JoinNico/Hovercraft_Control_System/hardware/SCH_V203无感无刷_2025-11-13.pdf

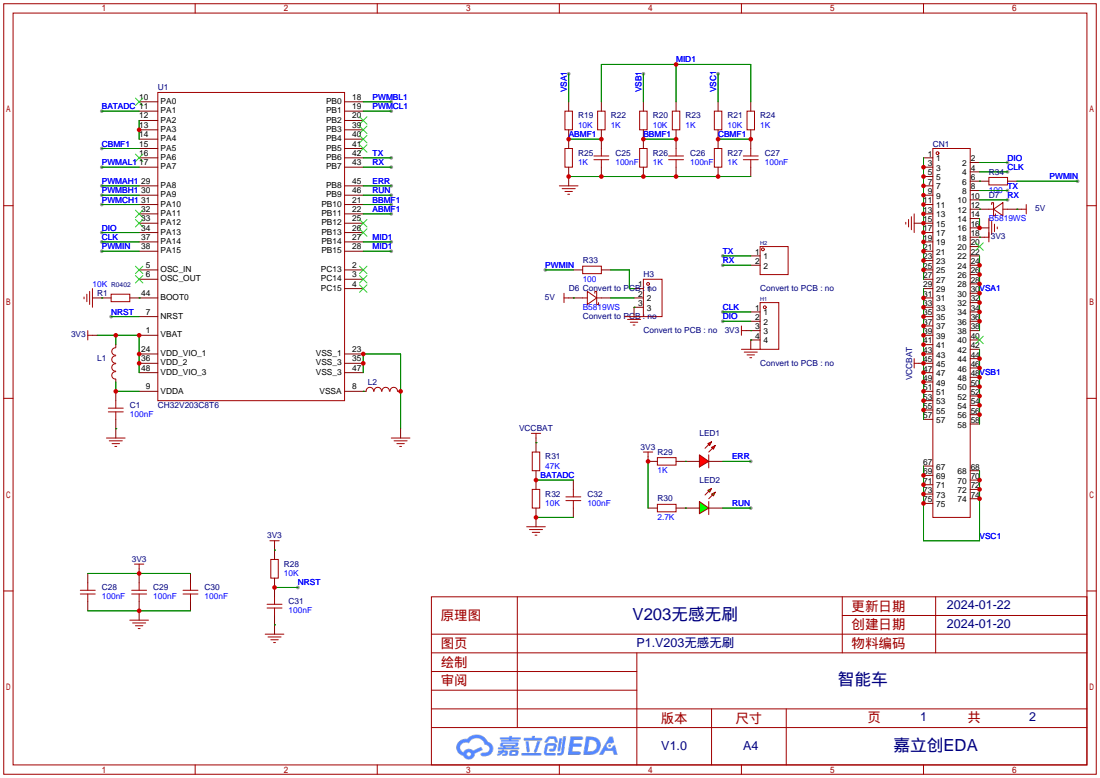
[picture p4: page 1]

Convert to PCB : no

# HO3 13 VB3 14 VS2 15 HO2 16 VB2 17 VS1 18

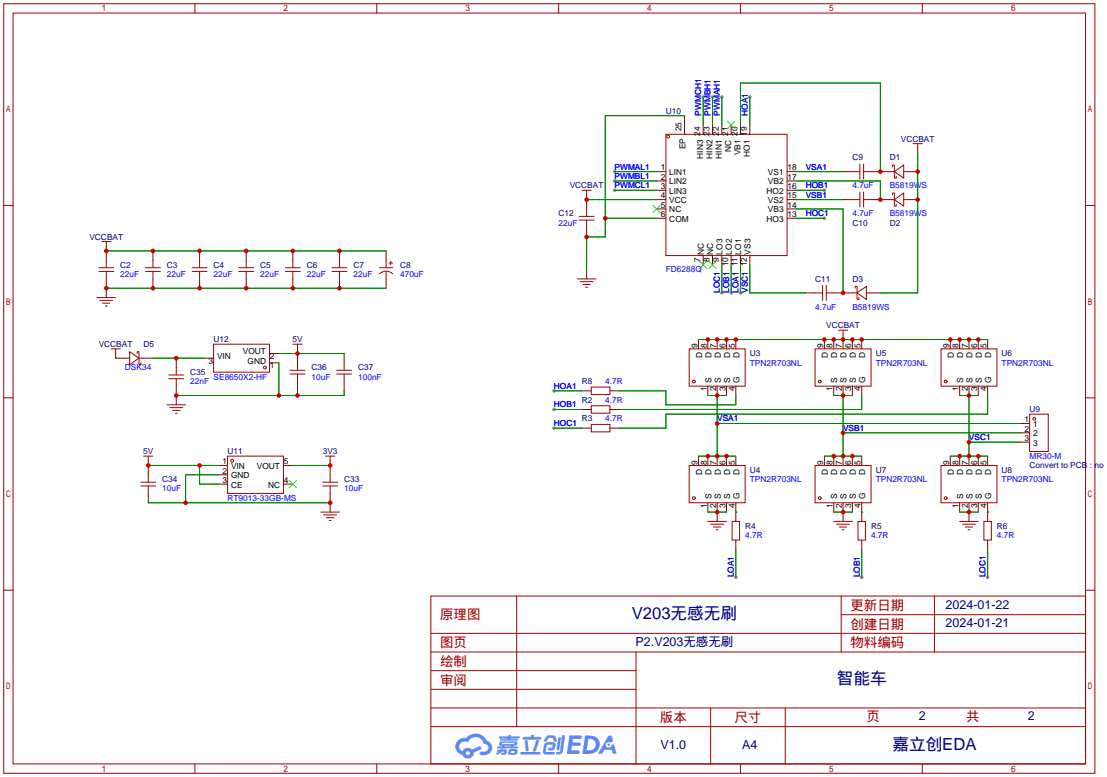
[picture p5: page 2]
