JoinNico/Hovercraft_Control_System/hardware/SCH_4路有刷驱动_2025-11-13.pdf

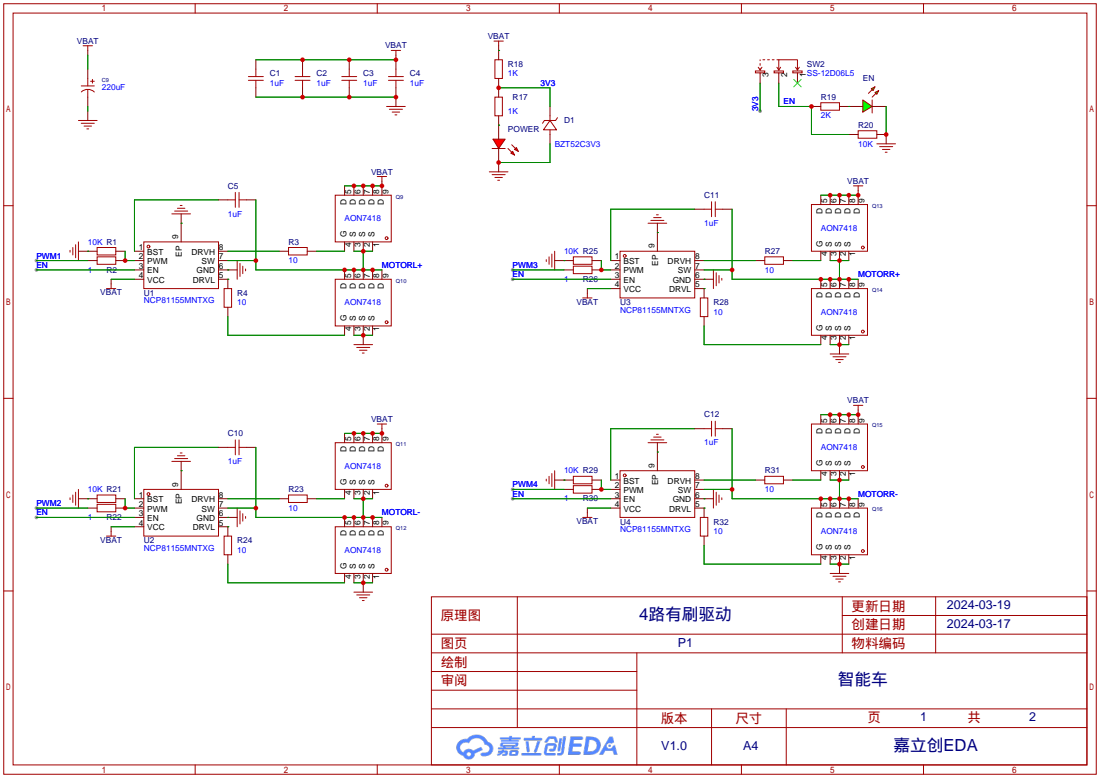
[picture p6: page 1]

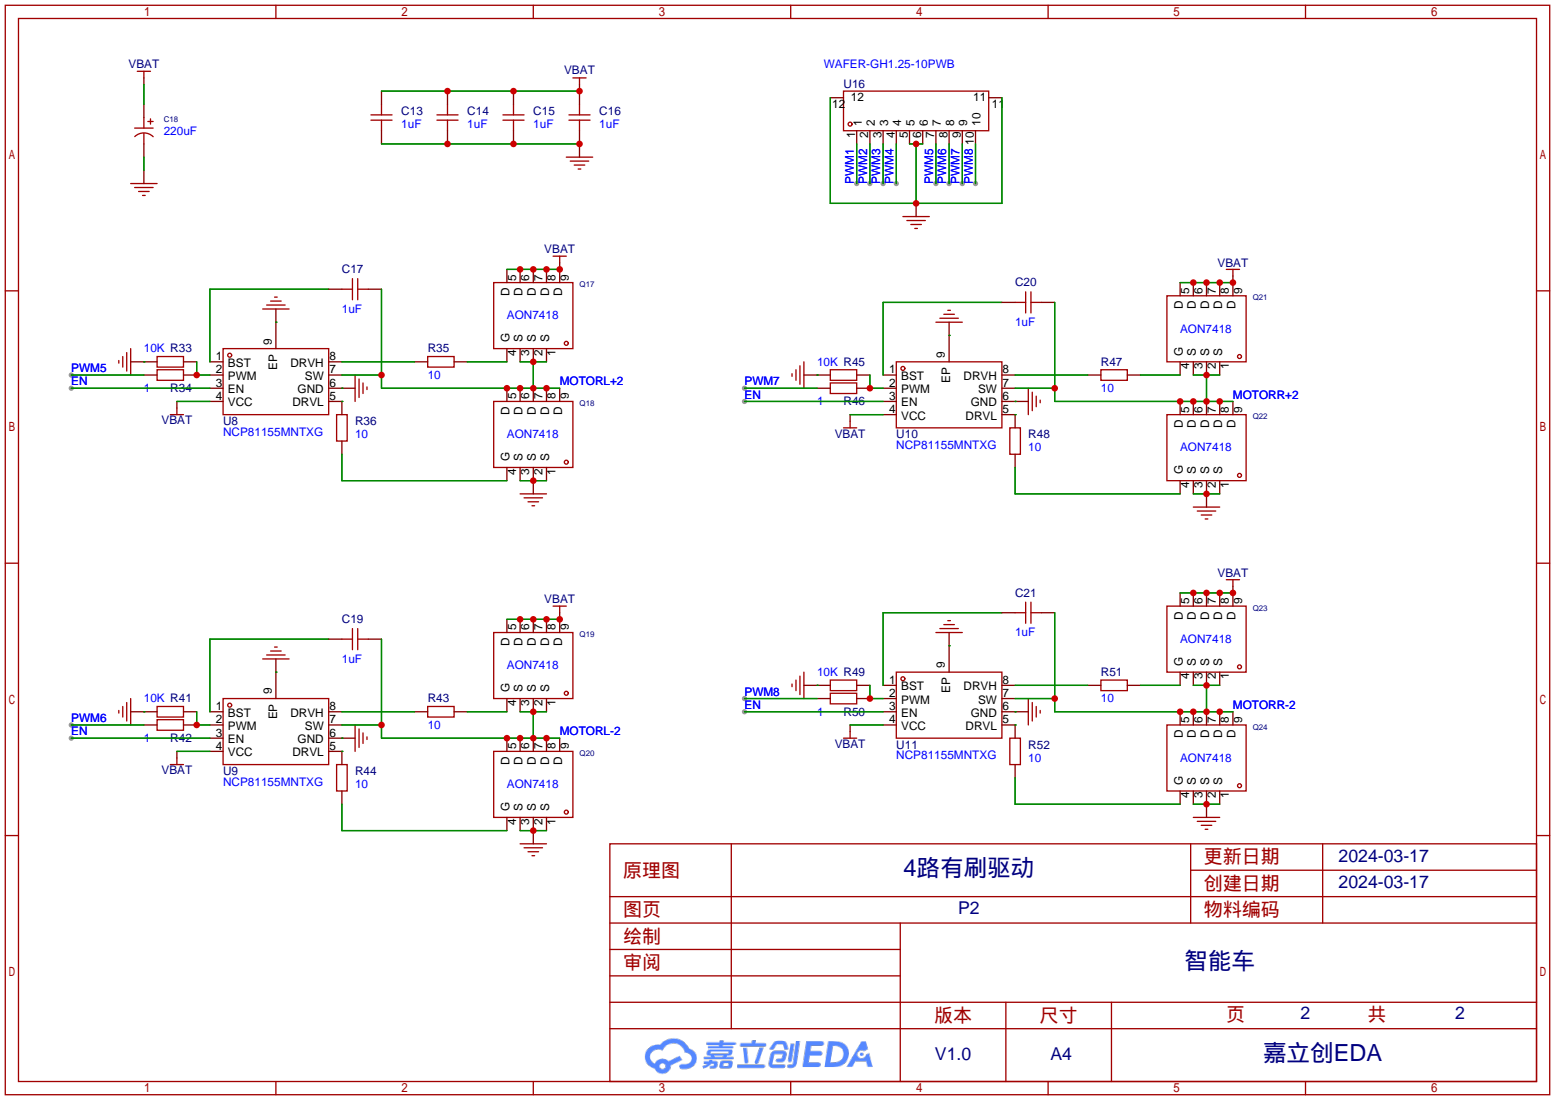
[picture p7: page 2]
