JoinNico/Hovercraft_Control_System/hardware/SCH_霍尔停车检测_2025-11-13.pdf

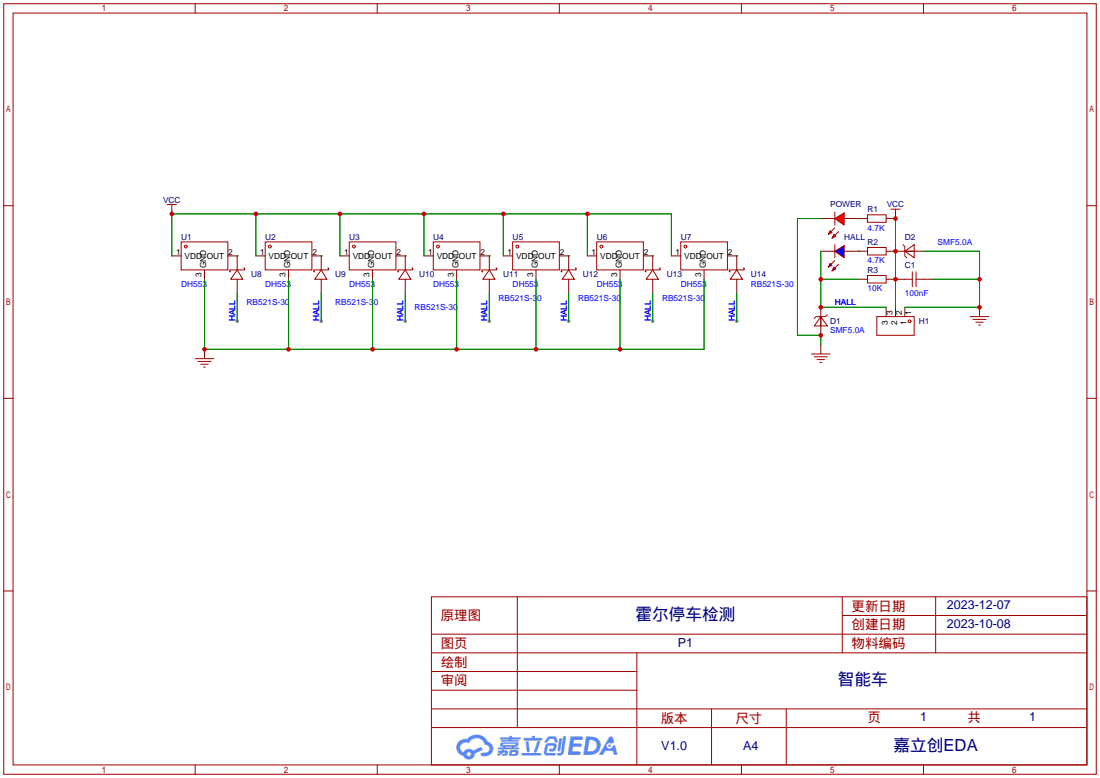
[picture p10: page 1]
