JoinNico/Hovercraft_Control_System/firmware/project/user/src/main.c

/*********************************************************************************************************************
* CH32V307VCT6 Opensourec Library 即（CH32V307VCT6 开源库）是一个基于官方 SDK 接口的第三方开源库
* Copyright (c) 2022 SEEKFREE 逐飞科技
*
* 本文件是CH32V307VCT6 开源库的一部分
*
* CH32V307VCT6 开源库 是免费软件
* 您可以根据自由软件基金会发布的 GPL（GNU General Public License，即 GNU通用公共许可证）的条款
* 即 GPL 的第3版（即 GPL3.0）或（您选择的）任何后来的版本，重新发布和/或修改它
*
* 本开源库的发布是希望它能发挥作用，但并未对其作任何的保证
* 甚至没有隐含的适销性或适合特定用途的保证
* 更多细节请参见 GPL
*
* 您应该在收到本开源库的同时收到一份 GPL 的副本
* 如果没有，请参阅<https://www.gnu.org/licenses/>
*
* 额外注明：
* 本开源库使用 GPL3.0 开源许可证协议 以上许可申明为译文版本
* 许可申明英文版在 libraries/doc 文件夹下的 GPL3_permission_statement.txt 文件中
* 许可证副本在 libraries 文件夹下 即该文件夹下的 LICENSE 文件
* 欢迎各位使用并传播本程序 但修改内容时必须保留逐飞科技的版权声明（即本声明）
*
* 文件名称          main
* 公司名称          成都逐飞科技有限公司
* 版本信息          查看 libraries/doc 文件夹内 version 文件 版本说明
* 开发环境          MounRiver Studio V1.8.1
* 适用平台          CH32V307VCT6
* 店铺链接          https://seekfree.taobao.com/
*
* 修改记录
* 日期                                      作者                             备注
* 2022-09-15        大W            first version
********************************************************************************************************************/
#include "zf_common_headfile.h"

#include "FreeRTOS_task.h"
//typedef enum
//{
//    FlASH_192_SRAM_128 = 0,
//    FLASH_224_SRAM_96,
//    FLASH_256_SRAM_64,
//    FLASH_288_RAM_32
//} FLASH_SRAM_DEFIN;
//
//void Config_Flash_SRAM(FLASH_SRAM_DEFIN SetFlashSRAM)
//{
//    uint8_t UserByte = FLASH_GetUserOptionByte() & 0xff; //get user option byte
//
//    switch(SetFlashSRAM)
//    {
//    case 0:
//        UserByte &= ~(0xc0); // SRAM_CODE_MODE = 00
//        break;
//    case 1:
//        UserByte &= ~(0xc0); // SRAM_CODE_MODE = 00
//        UserByte |= 0x7f;    // SRAM_CODE_MODE = 01
//        break;
//    case 2:
//        UserByte &= ~(0xc0); // SRAM_CODE_MODE = 00
//        UserByte |= 0xbf;    // SRAM_CODE_MODE = 10
//        break;
//    case 3:
//        UserByte |= 0xff;    // SRAM_CODE_MODE = 11
//        break;
//    default:
//        break;
//    }
//
//    FLASH_Unlock();
//    FLASH_ProgramOptionByteData(0x1ffff802, UserByte);
//    FLASH_Lock();
//}

int main (void)
{
    clock_init(SYSTEM_CLOCK_144M);      // 初始化芯片时钟 工作频率为 144MHz
    debug_init();                       // 务必保留，本函数用于初始化MPU 时钟 调试串口
//    wireless_uart_init();
    Delay_Init();
//    Config_Flash_SRAM(FlASH_192_SRAM_128 );
    my_flash_init();
    EC11_Init();
    UI_Init();
    motor_init();
    icm20602_init();
    Encoder_Init();
    adc_init(ADC1_IN9_B1,ADC_12BIT);
    //gpio_init(B0, GPO, 0, GPO_PUSH_PULL);
    buzzer_init();

    gpio_init(C4, GPO, 0, GPO_PUSH_PULL);

    ips200_init(IPS200_TYPE_PARALLEL8);

    while(1)
    {
        if(mt9v03x_init())
            ips200_show_string(0, 16, "mt9v03x reinit.");
        else
            break;
        system_delay_ms(500); // 短延时快速闪灯表示异常
    }

    ips200_clear();
    FreeRTOS_Start();
    while(1)
    {
        // 此处编写需要循环执行的代码

        // 此处编写需要循环执行的代码
    }
}
