JoinNico/Hovercraft_Control_System/(commit log)

2026-03-04 Rewrite the pid model
2026-03-05 Add double buffering on dvp camera
2026-03-06 Fix some image bugs
    [imageplus.c, imageplus.h]
