JoinNico/Hovercraft_Control_System/(notices)

Notices in the files:
firmware/project/user/src/isr.c:
Copyright (c) 2022 SEEKFREE Öð·É¿Æ¼¼
README.md:
License: GPL v3
